DirkSuave/autonomous-race-buoy/notes/development-log.md

# Development Log

## 2026-02-18 - Project Setup
- Created project directory structure
- Organized documentation folders
- Moved project summary into docs/
- Created hardware components specification
- Set up README with project overview

### Project Structure Created
```
autonomous-race-buoy/
├── docs/              # Project documentation
├── firmware/          # ESP32 code
│   ├── master/        # Master buoy
│   ├── slave/         # Slave buoys  
│   └── common/        # Shared code
├── hardware/          # Hardware specs
├── testing/           # Test plans
└── notes/             # This log
```

### Next Session Planning
- [ ] Define firmware architecture
- [ ] Set up ESP32 development environment
- [ ] Create common libraries structure
- [ ] Design LoRa protocol message format
- [ ] Implement GPS coordinate utilities
- [ ] Design state machine for Master buoy

---

## Session Template

### Date: YYYY-MM-DD
**Focus:**

**Progress:**
-

**Issues:**
-

**Next Steps:**
-

**Notes:**
-
