DirkSuave/autonomous-race-buoy/(commit log)

2026-02-14 Initial project setup: protocol definitions, hardware tests, and documentation
    - Added protocol.h with packet structures, state machine definitions, and error flags
    - Created hardware test sketches for LoRa (RFM95W), GPS (BE-880), and wind sensors
    - Added config.h with pin definitions for ESP32-S3
    - Created README with getting started guide and testing instructions
    - Added project summary documentation
    [config.h, gps_test.ino, lora_test_rx.ino, protocol.cpp, protocol.h]
2026-02-21 Fix common/config.h pin assignments for ESP32-S3
    All pins were incorrect for the ESP32-S3-DevKitC-1 (copied from
    original ESP32). Updates to match hardware/ESP32-S3-MIGRATION-SUMMARY.md:
    - LoRa CS: 5→10, IRQ: 2→21
    - GPS RX: 16→18
    - Motor PWM: 25/27→47/48 (GPIO 25-32 reserved for flash)
    - Battery ADC: 36→4 (ADC1, WiFi-safe)
    - Wind: speed 34→6, direction 35→5 (ADC1)
    - OLED I2C: SDA 21→8, SCL 22→9
    Also adds SPI bus pins, status LED pins, removes ESC direction pins
    (ESCs use servo-style PWM, not DIR signals), and fixes include guard
    (OLED defines were outside #endif).
    [config.h]
2026-02-21 Resolve protocol conflicts and document remote control unit
    Fixes all inconsistencies identified in gap analysis:
    Protocol (common/):
    - Wind threshold: 12° → 15°, hold radius: 5m → 3m
    - Comms timeout: 30s → 60s, wind stability window: 30s → 60s
    - Packet magic bytes aligned to hw spec (0xA5/0xAA/0x5A/0x55)
    - All structs: double→float coords, uint8_t XOR→uint16_t CRC16,
    __attribute__((packed)) to guarantee wire sizes
    - Add PKT_RC_START/STOP and BUOY_REMOTE for remote control
    - Add RcCommandPacket struct
    - Replace XOR checksum with CRC16-CCITT (polynomial 0x1021)
    Config:
    - GPS_BAUD: 115200 → 9600 (BE-880 factory default)
    - gps_test_display.ino: use config.h instead of hardco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
    [config.h, protocol.cpp, protocol.h]
2026-02-22 Add LoRa TX/RX tests (modules 4 & 5), PlatformIO config, and clangd setup
    - Convert lora_test_tx and lora_test_rx from .ino to PlatformIO .cpp
    - Add #include <Arduino.h> and fix include path to common/config.h
    - Fix while(!Serial) battery-boot hang with 3s timeout
    - Add platformio.ini with per-env build_src_filter for all test envs
    - Add .clangd pointing to lora_tx compilation database
    - Fix GPS_BAUD in config.h to 115200 (BE-880 configured baud)
    - Remove legacy tests/ directory .ino files
    - Validated: bidirectional LoRa link at 915 MHz, RSSI -28 dBm, SNR 9 dB
    - Validated: both boards operate on battery power without USB
    [config.h, gps_test.ino, main.cpp]
2026-02-22 Add compass test (module 3) for QMC5883L via BE-880 I2C
    - testing/compass_test/main.cpp: reads heading, X/Y/Z from QMC5883L at 0x0D
    - Displays heading on SSD1306 OLED and serial monitor
    - CALIBRATION_MODE 0/1 toggle: calibration mode collects axis min/max live,
    normal mode applies setCalibration() values for accurate heading
    - I2C scan on boot confirms 0x0D and 0x3C present before proceeding
    - Validated: heading changes smoothly on board rotation
2026-02-23 Add wind + compass sensor fusion test (Module 6)
    Converts wind_sensor_test.ino to a PlatformIO sketch and upgrades it
    with QMC5883L compass integration. Outputs vane_raw, vane_relative,
    compass heading, absolute wind direction, and heading error signal on
    serial and OLED. Adds [env:wind_sensor] to platformio.ini.
    [main.cpp]
2026-02-26 Refine system specification from design review session
    - protocol.h: add PKT_RC_RTH (0xB3), PKT_MASTER_STATUS (0xC1), MasterStatusPacket,
    and FLEET_STATE_* constants; update RcCommandPacket comment for RTH
    - remote-pinout.md: upgrade from 3 LEDs (amber/green/red) to 4 LEDs (blue/green/red/white);
    add full LED state table, button command mapping, and updated LoRa packet list
    - master-pinout.md: add GPIO 7 horn output (MOSFET driver → self-contained 12V marine horn)
    with circuit notes; add GPIO 7 to pin usage summary
    - components.md: add start horn section (self-contained 12V horn, IRLZ44N MOSFET);
    document 3-min/5-min IRSA sequence with confirmed blast durations (long=2s, short=0.75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
    [protocol.h]
2026-02-26 Add JSN-SR04T collision avoidance sensor test (Module 9)
    Three waterproof ultrasonic sensors (forward, port-45°, starboard-45°)
    provide 150° forward arc coverage during transit. Sequential firing
    eliminates acoustic cross-talk; 90 ms cycle with OLED + CSV serial output.
    - testing/ultrasonic_test/main.cpp: Module 9 test sketch
    - platformio.ini: [env:ultrasonic_test] environment
    - common/config.h: ULTRASONIC_TRIG/ECHO_FWD/PORT/STBD pin defines (GPIO 15/16/19/20/22/23)
    - common/protocol.h: ERROR_FLAG_OBSTACLE 0x40
    - hardware/pinouts/slave-pinout.md: ultrasonic section + updated pin tables
    - hardware/pinouts/master-pinout.md: same
    - testing/TEST-PLAN.md: Module 9 entry with wiring, geometry,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
    [config.h, main.cpp, protocol.h]
2026-02-26 Power ultrasonic sensors from 3.3V to avoid ECHO level-shifting
    AJ-SR04M/JSN-SR04T rated 3–5V; running from ESP32 3.3V rail means ECHO
    pin stays within GPIO input spec — no voltage divider needed on 3 echo lines.
2026-02-26 Update ultrasonic sensor supply to 3.3V in pinout docs
    Matches TEST-PLAN.md change: sensors run from ESP32 3.3V rail, not 5V
    buck converter, to keep ECHO pin within ESP32-S3 GPIO input spec.
2026-02-26 Add ultrasonic sensors to slave buoy power budget
    3× AJ-SR04M at 3.3V, sequential firing: ~5–15 mA average (transit only).
    Electronics total updated to ~155–265 mA.
2026-02-26 Add power budget to master buoy pinout
    Covers all master-specific hardware: Davis anemometer, WiFi AP (config
    mode only), horn (12V rail via MOSFET), ultrasonic sensors, thrusters.
    Electronics total ~160–270 mA normal operation.
2026-02-26 Add power budget to remote control unit pinout
    ~60–100 mA typical (LoRa RX + 1 LED). 500 mAh LiPo gives 5–8 hours —
    sufficient for a race day. Includes charging time estimates via TP4056.
2026-02-26 Fix documentation inconsistencies across config, pinout, and spec files
    GPS baud rate (be-880-gps.md, CLAUDE.md):
    - Corrected from 9600 to 115200 throughout
    - Added hardware-verified note: at 9600 baud no valid data displayed;
    switching to 115200 immediately restored data flow and fix acquisition
    - Added warning not to revert, and reconfiguration instruction for
    replacement modules arriving at factory default
    CLAUDE.md additional fixes:
    - config.h is now correct for ESP32-S3 (was labelled OUTDATED — it has been fixed)
    - Pin table updated to reflect current config.h values including ultrasonic pins
    - Dev environment updated: PlatformIO configured, sketches are .cpp not .ino
    - RC interf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
2026-02-26 Fill gaps and fix stale content in project-summary.md
    - Update date to 2026-02-25
    - Slave buoys: propulsion now specified (bilge ESCs, LEDC PWM 100 Hz);
    failsafe timeout now 60s (was "set duration"); collision avoidance added
    - Remote Control: fully specified (NodeMCU-32S, IP67, 4 LEDs, 2 buttons,
    buzzer, drift alert, LoRa link, power budget) — replaces "TBD"
    - Race Logic: added Race Countdown & Start Horn section (3/5 min, IRSA
    blast pattern, horn on master only, single-press trigger)
    - Hardware Specifications: propulsion and remote control no longer TBD;
    added collision avoidance sensors, horn, GPS baud 115200
    - Course Layout: removed duplicate hardware spec lines (copy/paste art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
2026-02-26 Overhaul firmware-architecture.md to match current project state
    Directory structure:
    - Added root common/ (config.h, protocol.h, protocol.cpp) — the actual shared headers
    - Added firmware/remote/ for NodeMCU-32S RC firmware
    - Added testing/ directory listing with module status
    Common libraries:
    - LoRa: all 7 packet types, CRC16-CCITT, deterministic reply stagger
    - Added Collision Avoidance module (AJ-SR04M, Mode 1, zone logic)
    - Utils: clarified rolling buffer and geometry scope
    Master firmware:
    - Clarified two parallel state machines: race SM (REPOSITIONING→LOCKED)
    vs buoy operational SM (STATE_INIT→STATE_FAILSAFE) — previously conflated
    - Core modules: added Horn Controller, B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
2026-02-26 Fill gaps in hardware/components.md
    Controllers: split buoy (ESP32-S3) vs RC (NodeMCU-32S) with key pin notes
    Propulsion: removed TBD — spec is defined (LEDC PWM GPIO 47/48, 100 Hz,
    standard ESC signal); hardware procurement still pending
    Navigation & Sensors:
    - GPS: added 115200 baud note (hardware-verified, do not revert to 9600)
    - Added Collision Avoidance section (AJ-SR04M ×3, 3.3V supply, zone thresholds,
    GPIO assignments, transit-only activation) — was missing entirely
    - Wind sensor: added GPIO assignments and pulse/analog details
    Communication: added LoRa radio parameters (SF7, 125kHz, CR4/5), library,
    and GPIO assignments for both buoy and RC SPI buses
    Power System: split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
2026-02-26 Fill gaps in hardware/README.md
    Quick Reference:
    - Added remote-pinout.md to pinout diagrams
    - Fixed datasheet list (QMC5883L not HMC5883L, added AJ-SR04M, removed TBD)
    BOM:
    - Per buoy: added AJ-SR04M ×3, corrected ESC/thruster to "pending procurement",
    detailed resistor values and GPIO assignments
    - Master additional: added horn, MOSFET, gate resistor, flyback diode
    - Remote Control: replaced all TBDs with full component list (NodeMCU-32S,
    4 LEDs, 2 buttons, buzzer, TP4056, IP67 enclosure)
    - Total system: corrected to 2 RC units (was 1)
    Power Budget:
    - Master: corrected WiFi 80-120→160-240 mA, anemometer 5-10→1-5 mA,
    electronics total 200-300→160-270 mA; added ultrasonic sens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
2026-02-26 Rewrite README to reflect current project state
    - Updated overview: horn, RC, differential thrust, LoRa specifics
    - Quick links: added firmware-architecture, hardware README, test plan,
    all three pinout files
    - System components: table with MCU, qty, and role for all 5 units
    - Hardware platform: full spec for buoys and RC — no TBDs; GPS baud 115200,
    AJ-SR04M sensors, propulsion pending procurement, MOSFET horn
    - Current status table: 9-module test progress, firmware not started
    - Directory structure: added common/, firmware/remote/, hardware/pinouts/
    - Build instructions: pio commands and available env names
2026-02-26 Fix remaining gaps in CLAUDE.md
    - Removed stale Arduino IDE reference from dev environment section
    - Race state machine: Stable→Countdown (with horn), added RTH state
    - Protocol: expanded from 4 to all 7 packet types with hex values
    - Error flags: added OBSTACLE (0x40)
    - Firmware structure: added remote/ directory (NodeMCU-32S)
    - Key hardware: added AJ-SR04M collision avoidance and master horn
    - Reference docs: added all 3 pinout files, updated testing description,
    removed migration summary from critical path (config.h now correct),
    updated firmware-architecture description
2026-02-26 Fix gaps in hardware spec files
    - rfm95w-lora.md: SF7 fixed; 7-packet protocol table; buoy IDs corrected;
    deterministic reply stagger (replaces random)
    - esc-thrusters.md: removed TBD placeholder title; GPIO 47/48 applies to
    both master and slave buoys
    - oled-display.md: Wire.begin(8,9) added to example; slave states aligned
    with protocol.h enum (INIT/DEPLOY/HOLD/ADJUST/RECOVER/FAILSAFE);
    LED note updated (GPIO 38/39 are in design)
    - esp32-s3.md: GPIO 7 corrected to horn MOSFET (not button); GPIO 15/16/
    19/20/22/23 corrected to ultrasonic sensor pins (not buttons); WiFi
    current 80-120→160-240 mA; voltage divider 5:1→11:1 (100k+10k);
    section heading updated to PlatformIO
    - d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
2026-02-26 Mark Module 3 compass test as ready
    - testing/TEST-PLAN.md: updated Module 3 entry with full wiring table,
    calibration procedure, and expected serial/OLED output; status TODO→Ready
    - README.md: Module 3 status TODO→Passing
    - hardware/README.md: compass test checkbox ticked
    Sketch at testing/compass_test/main.cpp — compiled clean, uploaded OK.
    QMC5883LCompass library, I2C on GPIO 8/9 (shared with OLED at 0x3C).
    Compass at 0x0D; calibration mode built in.
2026-02-26 Skip Module 1 (OLED standalone) — covered by Module 2
    OLED is fully exercised by the GPS+OLED test. A dedicated OLED-only
    sketch adds no value if Module 2 passes.
2026-02-26 Document collision avoidance behaviour with pre-firmware open questions
    - project-summary.md: expanded Section 3 with full Zone 1/Zone 2 logic,
    transit speed cap (1 m/s), active state clarification; added ⚠️ block
    with 4 decisions to resolve before firmware implementation
    - firmware-architecture.md: expanded collision avoidance module spec with
    same zone logic detail and matching ⚠️ open questions block
